danilo-alxnder/PowerAmplifier/Assigment.pdf

# Project part I: Design of an audio amplifier

## (CSC-CDC-AB configuration)

Abstract—An audio amplifier is presented and designed to drive a 4Ω-loudspeaker using an input signal of max 100mVRMS and power supply 10V. A three-stage-amplifier is used, starting with a common source circuit, next a common drain circuit, and ending with a class AB amplifier. This cascade is needed in order to get high input impedance, low output impedance, and efficient voltage transfer between stages. The distortion of the amplifier must be as low as possible. This is done by avoiding clipping and cross-over distortion.

I. INTRODUCTION

For the third module of Electrical Engineering at University of Twente, the task given was to design an audio amplifier. The required operating conditions are 100mVRMS input signal and a power supply of 10V. The audio amplifier is designed to drive a 4Ω loudspeaker. In order to accomplish this, first a common source circuit is used. This circuit has a high input impedance and is responsible for the voltage gain. Given the mentioned constrains to satisfy the requirements of a typical audio amplifier, the voltage gain must be around 30. Next, a source follower is implemented. This sub-circuit is used to achieve an efficient voltage transfer between the first and the last stage. Lastly, a class AB is used to deliver the current needed for the loudspeaker. This report will discuss the design process and the highlights of the audio amplifier. Experimental proof will be shown, and finally the issues faced while achieving this task will be discussed.

II. ANALYSIS AND DESIGN

A step by step explanation for the design process of the circuit stages will be done in this section. The schematics in the figures are from the final circuit itself.

A. STAGE 1: COMMON SOURCE CIRCUIT

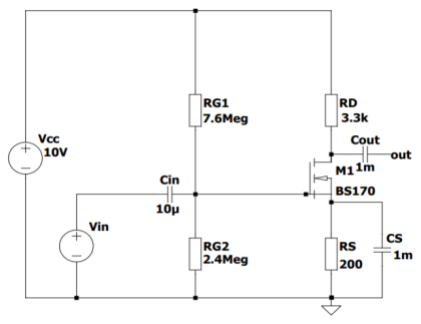
[picture p1: figure]

Figure 1 Input stage; common source circuit

The input impedance of the common source circuit is relatively high. This is needed for maximum transfer from the input source (e.g. laptop audio port) to this first stage. The circuit behaves as a voltage divider: in order to get most of the voltage to the first stage its input impedance needs to be high in comparison to the impedance of the signal source. This stage also delivers the voltage gain, given by the following equation: AV = −gm ∙RD [1] (the minus is not included in the rest of the calculations, because this does not affect the performance of the audio amplifier). In order to get enough gain, the resistor values are calculated using the equations for the given stage which were fitted for biasing. Also, the bias settings need to be in such a way, that the output voltage can get maximum swing. This means that the bias voltage at the output of this stage needs to be approximately 6V. The positive peak can then reach the supply voltage VCC, (the amplitude of the output signal of this stage is 4V, and the minimum value is 2V), which is just above the threshold voltage of the MOSFET. A gain of 30 is the maximum possible, because 0.141∙30 = 4.23V, which is about the maximum voltage swing. The output impedance is approximately the same as RD, which is relatively high, so a buffer stage is needed.

The resistor values need to be calculated. Firstly, the gain needs to be 30. But it is known that there will be some loss in the source follower, so for the calculations 32 is chosen. The output bias voltage of this stage is chosen to be 6V, because then maximum swing is possible (not 5V, because of the threshold voltage).

ID =

VCC−Vout
RD
→ IDRD = 4 | (1)

Also, the voltage gain equation is known K =0.04 A/V² and VT =1.9V (same value as discussed in the measurement section.)
AV = gmRD = √2KIDRD = 32 → RD = 3.2kΩ (2)

An available resistor value will be chosen: 3.3kΩ Then, the other resistances will be calculated. The equation ID =
1
2

K(VGS − VT)

2
is known. Then:

VG − VS = √
2ID K
+ VT = VG − IDRS | (3)

The value for RS may not be too high, because clipping at the negative side of the signal can occur. Therefore, RS = 200Ω is chosen to avoid this issue. Thus:
VG = √
2ID
K
+ VT + IDRS ≈ 2.4V | (4)

Then the bias values for the gate are quite easy: RG2 = 2.4MΩ and then RG1 = 7.6MΩ.

B. STAGE 2: COMMON DRAIN CIRCUIT

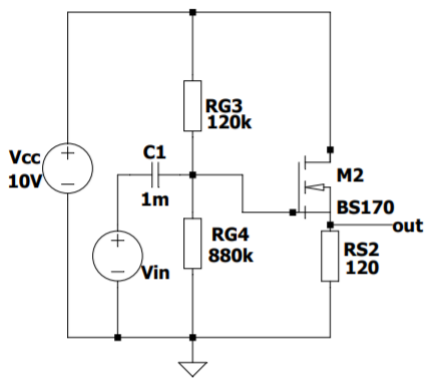
[picture p2: figure]

Figure 2 The common drain circuit

The second stage is a common drain circuit, which has a high input impedance and a low output impedance, perfectly fitting between the first and last stage. The gain will be always lower than 1 (see the equation in Table I), but there will not be a significant loss if it is close enough to 1. Therefore, this gain is calculated and set at least 0.90, because then the loss is acceptable. Moreover, the output impedance may not be too high. Therefore, RS cannot be too big or too small. Choosing a value of 120Ω, RG3 and RG4 can be calculated, using equation 4 again. Choosing ID = 50 mA, results in RG3 = 120kΩ and RG4 = 880kΩ. These resistor values result in rout=9Ω and AV = 0.93. The equations used for calculating this are shown in Table I.

Table 1 SMALL SIGNAL PROPERTIES OF THE SOURCE FOLLOWER [1]

Voltage gain | gmRS AV = gmRS + 1
rout | 1 gm
rin | RG1//RG2
C. STAGE 3: CLASS AB AMPLIFIER [2]

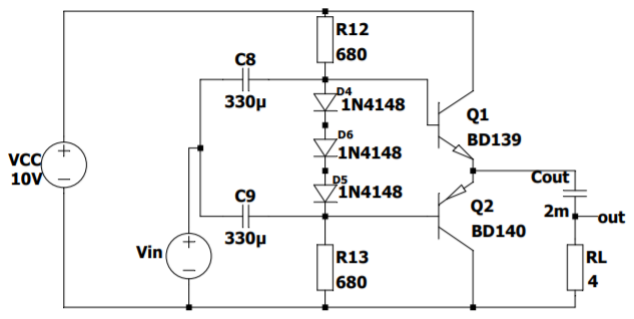
[picture p3: figure]

Figure 3 The class AB-amplifier

Up until now the two stages previously discussed will deliver an amplified input signal. The next step is used to ensure a maximum current driving to the load. This would have not been possible with the first two stages. Their transistors always consume power even if there is no input signal, therefore, providing less current and less power. A solution for this is to implement a class AB amplifier. They not only have a low output impedance but also low distortion when properly biased.

Thus, in order to accomplish this, the following considerations are taken:

a) The use of a fixed biasing voltage allows each transistor conduct one-half of the input cycle.
b) To put the transistors in active operation a voltage difference between the base and emitter of each BJT must be higher than 0.6V.
c) The current seen at the load depends on the output impedance of the power transistor.
d) Since the circuit acts as a pull and push amplifier one of the transistors will take charge of the positive half input signal. Thus, reducing the analysis to only one transistor. Such one being a common collector circuit.
e) Lastly, because power dissipation is avoided a cascade of diodes (instead of resistors) meeting the condition of literal b) is required.

All things considered, Figure 3 can be treated as a common collector circuit, when the input signal is at its positive side. But when the negative part of the signal, the other transistor is working. First, the diodes between the pair of transistors is shorted. Their resistance is negligible and make calculations easy. Secondly, the PNP transistor is seen as an open loop until the negative part of the input signal is reached. Then, the 4Ω resistance is placed as the load of this new configuration. Calculating the transfer function of this set up, the following equation is obtained:

Vout

Vin

=

gmRL
1+ gmRL

Now, since a common collector circuit acts a voltage buffer a gain of 0.99 is chosen. Thus
100
1 +100 =

gmRL
1+ gmRL

Equating both sides and solving for IC:

IC =

100
40 ∙ RL

= 625mA

Where gm ≈ 40IC stands for the transconductance of the BJT power transistor. The next step is to calculate the resistor values with the current obtained in the above equation. This is done by realizing that the node where both transistors meet each other is at 5V. Thus, for the common collector circuit of this analysis, the voltage over resistor R12 should be 4.4V. Looking at the datasheet of the transistor used in the real circuit it is found that the current gain is around 100 when IC is 625mA. Applying Ohm’s law this results in 700Ω. During measurements the available resistor value of 680Ω was chosen as it did not affect the biasing.

Table 2 SMALL SIGNAL PROPERTIES OF AB AMPLIFIER

Voltage gain | gm(1+∝)RL AV = ∝ +gm(1+∝)RL
rout | ∝ RL// gm 1 + gm (RL// ∝ ) gm
rin | RL(1+∝)//(RB1//RB2 )
D. WHOLE CIRCUIT

When connecting the three stages to each other, the complete amplifier is the result. This circuit can be seen in Figure 4. The gain for this circuit is not exactly the same as the gain of the common source circuit , because the gain of the source follower and the AB amplifier is less than 1. When multiplying those two voltages gain equations, the result is: AV = 0.99 ∙ 0.93 ∙ 32 ≈ 29.

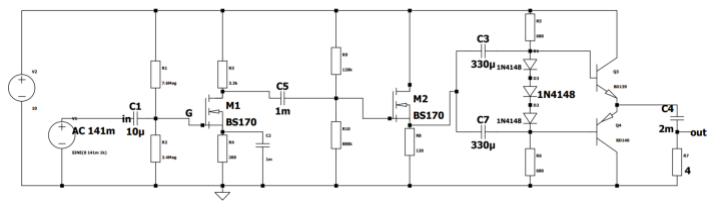
[picture p4: figure]

Figure 4 The complete amplifier circuit

III. RESULTS

A. Simulations

In this section, the simulations of the total amplifier circuit are presented:

Voltage Gain

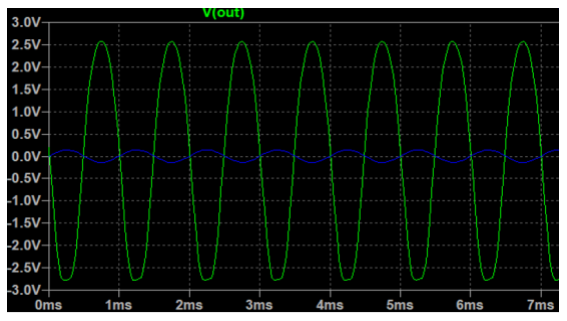
[picture p5: figure]

Figure 5 Simulation Voltage Gain

Starting with the voltage gain. A proper biasing for the different stages resulted in Figure 5. There, in green colour the output signal is shown. A close analysis reveals an amplitude of 2.7 volts. This corresponds to a voltage gain of around 20.
Bode plot

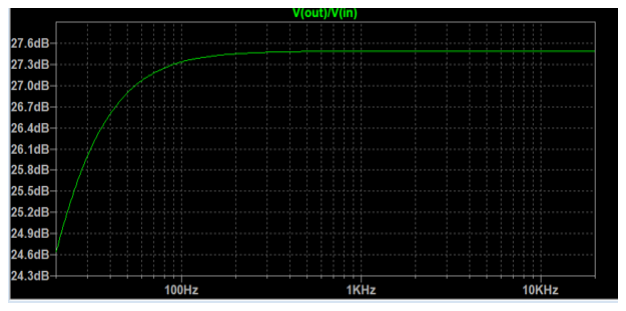
[picture p6: figure]

Figure 6 Simulation Bode plot

Figure 6 presents a Bode plot obtained in LTSpice. Looking at the top part in the y axis, a voltage gain of 23 is calculated. This corresponds to 27,4 dB within a bandwidth of 20Hz to 20kHz.

Distortion

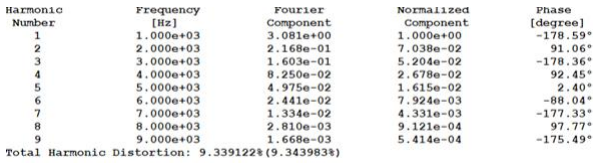
[picture p7: figure]

Figure 7 Screenshot of THD simulation

Accounting to the fact of a slightly distorted signal at the negative peaks where it is not perfectly rounded, an analysis to measure the distortion of the audio amplifier was carried out. [3]. This resulted in a THD of 9.33% as it can be seen in Figure 7.

Input impedance

The input impedance in the simulation is calculated using the values of the current passing through the input terminal and the voltage across it. Using Ohm’s Law, the result is 2,02MΩ

Output impedance

In a similar manner, the impedance as seen at the output terminals of the audio amplifier is 0.031Ω

B. Measurements and Performance

Before collecting measurements, in order to match the K parameter of the MOSFET used in the first two stages and the one in simulations, a test with my-DAQ is run. A set of instructions is followed. MATLAB is used and the transistor analyser studied during Lab sessions is put into practice [4]. It is found that the K-value is 0.04 A/V²
and the threshold
voltage is 1.9V. Marginally different, reason for which these parameters were changed during simulations. With this set up the biasing is readjusted, and the measurements are taken.

Voltage Gain

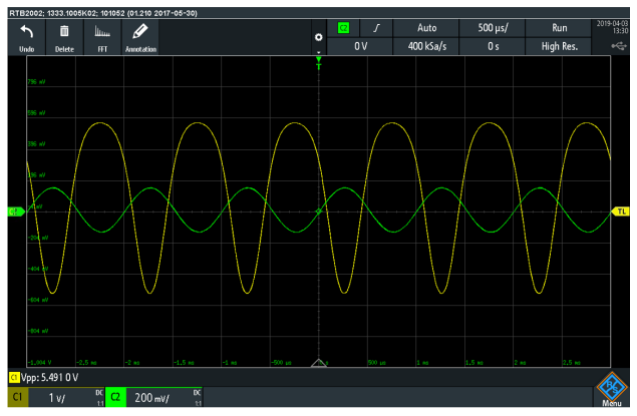
[picture p8: figure]

Figure 8 Real amplifier voltage gain; green: input, yellow: output

Figure 8 shows the output signal in the real circuit. The yellow line corresponds to the output signal whereas the green one to the input. A voltage of 5.49 peak to peak is observed, thus, calculating an amplitude which produces a gain of 19 times.

Bode plot

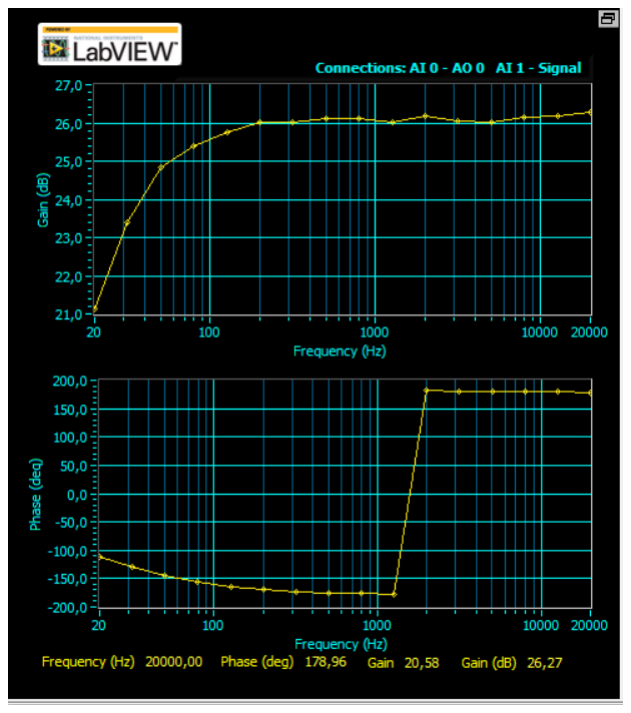
[picture p9: figure]

Figure 9 The measured Bode Plot

In figure 9 the analysis done with the Bode Analyser of my-DAQ is shown. In the window one can see that the cut-off frequency is rounding the 30Hz. This can be explained due to a relatively small (330μF) output capacitor which was used when doing this measurement. When a bigger capacitor (2mF) was used instead of the previous one, the cut-off frequency would have been lower than 20Hz, just as in the simulation. The gain in this figure is 26dB (20 times).

Distortion

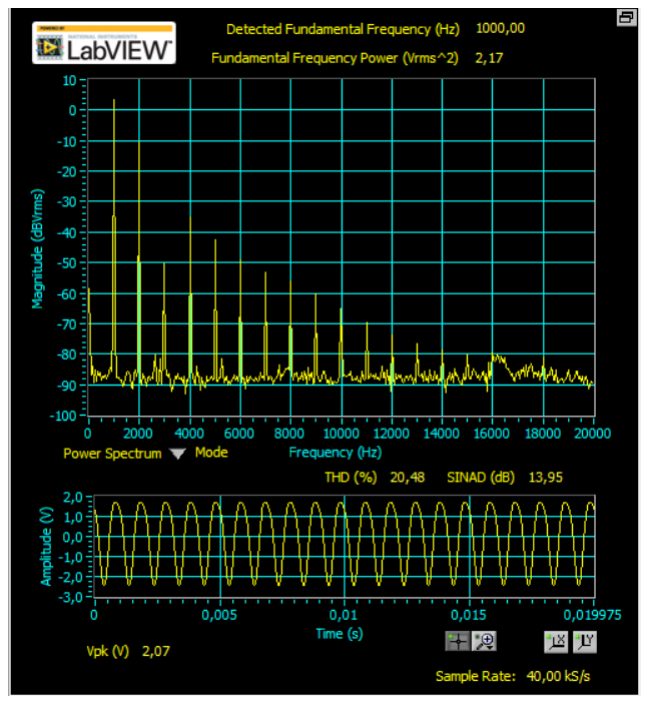
[picture p10: figure]

Figure 10 Measured Fourier transform

In Figure 10, the Dynamic Signal Analyzer was used to analyse the real circuit. As shown, the level of distortion THD is approximately 20%. This value, however, can be observed when looking to the output wave, in Figure 8. There, the yellow sinusoidal wave being the output presents positive peaks that are significantly wider than the negative ones. The green line is the input of 100mVRMS, and it used as a point of reference.

Input impedance

The value for the impedance is determined by measuring the current and the voltage seen at the input ports of the audio amplifier; 1.28 MΩ is obtained. The multimeter used for this purpose was the Agilent 34401A Multimeter and the calculation was done using Ohm’s law.

Output impedance

Applying the same concept to measure the input impedance the value obtained during real experimentation resulted in 0.062Ω. This time, the current measured was at the node of the emitter between the two power transistors and the load. Similarly, the voltage used in this case was the output voltage gain.

Table 3 Performance summary

Characteristics | Simulated | Measured
rin | 2.02MΩ | 1.28MΩ
rout | 0.031Ω | 0.062Ω
AV | 23 | 19
THD | 9.33% | 20%
Bandwidth | 20-20kHz | 30-20kHz
IV. | DISCUSSION AND CONCLUSION

Throughout the process of design, simulation, and testing, some issues became apparent which needed to be resolved.

One of the issues faced was the unknown k-factor. Thus, the first trial was done using the value of the k-factor from

LTSpice, however this resulted in distortion. This was resolved by implementing a proper method to derive the value for the used MOSFET, namely the method used in one of the labs of the third module.

In the pitch, the circuit design was slightly different than it is now. Some changes have been made, listed down here:

1. Capacitor values changed. Some capacitor values were chosen too big (1 mF for most of them). This would result in a high time constant τ (around 4s). This is avoided by choosing lower capacitances.
2. The resistor values have changed. Biasing was not done very properly. Also, the biasing was done using the simulation K and VT, which are not the true values.
3. The input of the class AB was placed between the two diodes during the pitch. Because crossover distortion was happening, another diode was added to ensure the required bias voltages at the bases of the transistors. Therefore, the input was split into two different inputs, otherwise it could not be in the middle of the diodes.
4. The biasing of the source follower was first done by using the bias voltage of the input stage, but because this one was changed, also this bias changed. That is not wanted, so two biasing resistors were added to this stage.
5. For the transistors at the output stage, first the BC550 and the BC560 were chosen, however these transistors cannot handle the required current. Therefore, they are replaced by high current transistors (BD139 and BD140).

The aim of this project was to design an audio amplifier circuit which fits the requirements and restrictions given. The final circuit design was able to drive the 4-ohm loudspeaker with the limitation of 10V supply, however distortion was clearly audible. This was seen through the distortion levels of the output signal (Figure 10). Taking this into consideration, the design of the amplifier circuit could be improved in some areas. For example, the bias settings could be improved even more. Also, by boosting the supply voltage (e.g. using a step-up-converter) the amplification could have been higher while clipping and other kinds of distortion would be avoided more.

Another improvement that can be made, is to add a heatsink to the power transistors in the class AB amplifier, because they were heating up significantly.

V. REFERENCES
1. A. J. Annema, ELECTRONICS. Oct 2018. https://app.perusall.com/courses/electronics-2018-2019/bookelectronics (https://app.perusall.com/courses/electronics-2018-2019/bookelectronics)
2. https://www.electronics-tutorials.ws/amplifier/class-ab-amplifier.html (https://www.electronics-tutorials.ws/amplifier/class-ab-amplifier.html) Accessed: 04/04/2019
3. Michiel, “Amplifier THD Simulation,” Canvas. [Online]. Available:
https://canvas.utwente.nl/courses/3258/pages/circuit-simulations?module_item_id=52685. (https://canvas.utwente.nl/courses/3258/pages/circuit-simulations?module_item_id=52685)
4. A. J. Annema and M. O. Alink, Module 3 Project and Lab Exercises Manual 2018-2019. .. https://app.perusall.com/courses/electronics-2018-2019/module-3-projectmanual_2018-2019_v3a (https://app.perusall.com/courses/electronics-2018-2019/module-3-projectmanual_2018-2019_v3a) Accessed: 02/04/2019
