danilo-alxnder/PowerAmplifier/Distortion.jpg

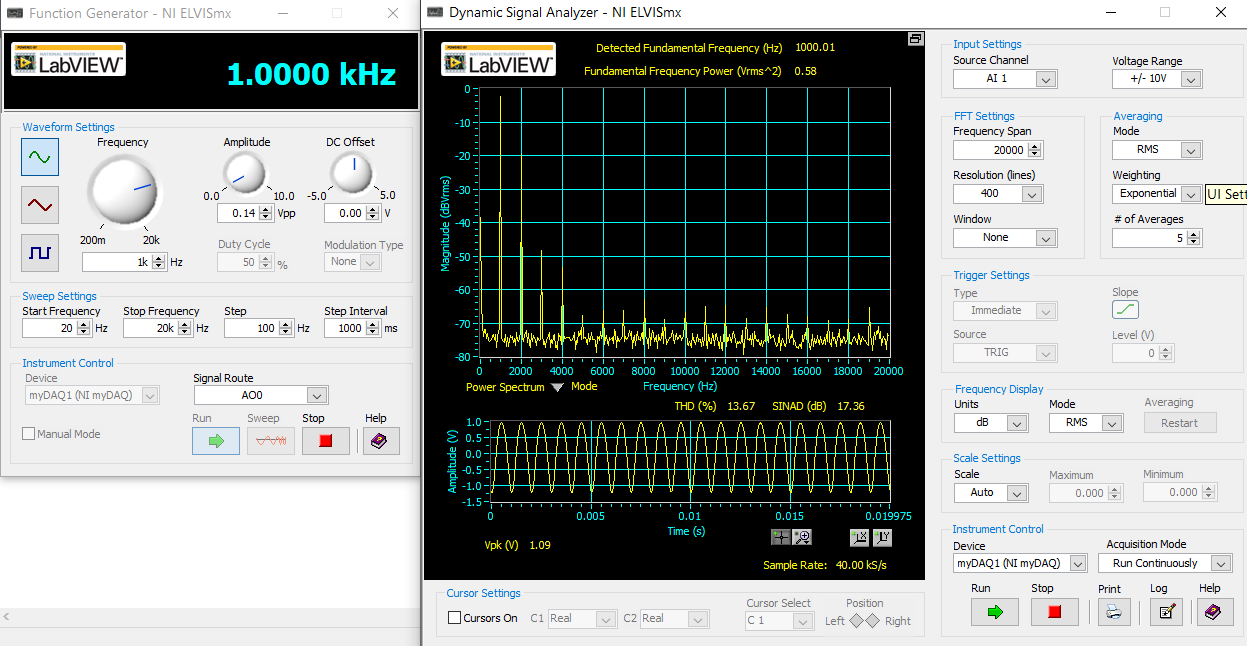
Distortion.jpg
