danilo-alxnder/PowerAmplifier/Oscilloscope_data.PNG

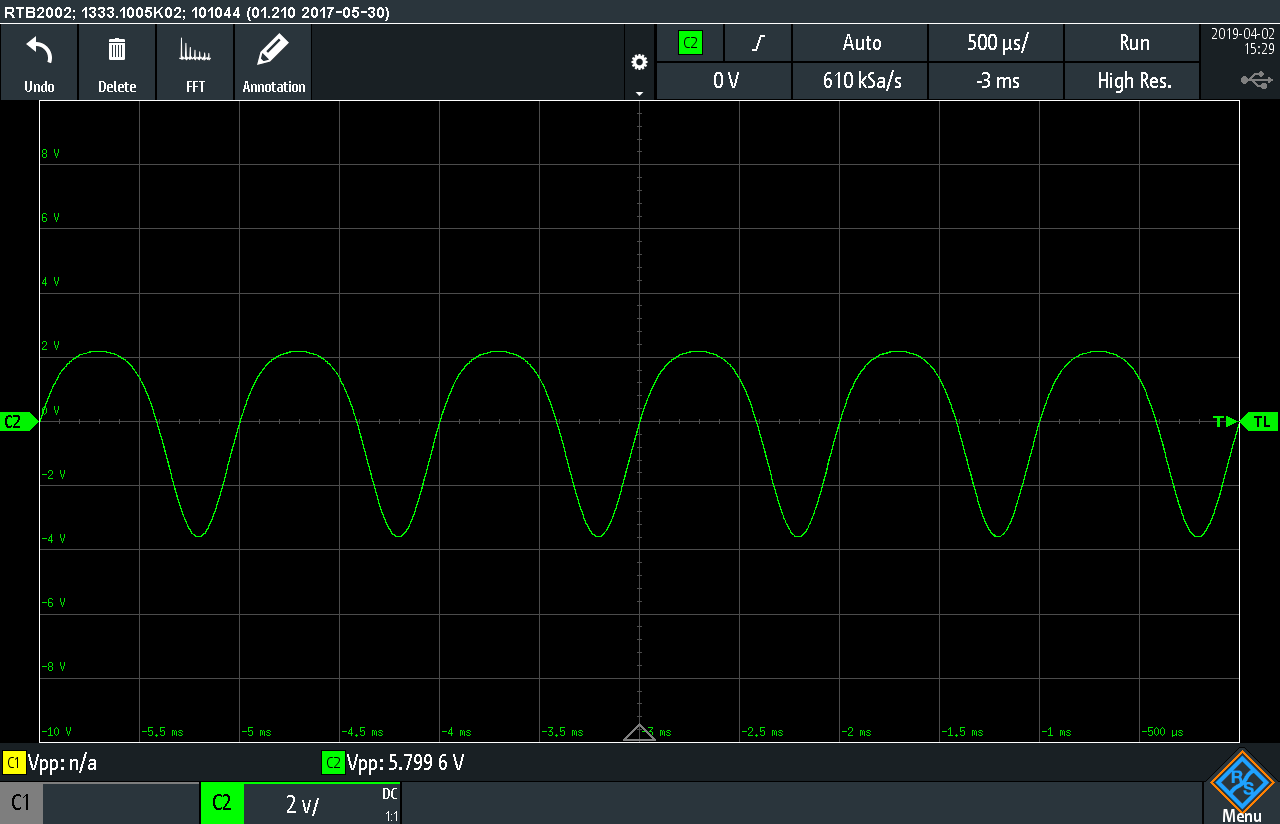
Oscilloscope_data.PNG
