danilo-alxnder/PowerAmplifier/CSC circuit amplifier.asc

C1: cap; 1m
C2: cap; 10µ
C3: cap; 1m
C4: cap; 10µ
C5: cap; 10µ
M1: nmos; BS170
M2: nmos; BS170
R1: res; 7k
R2: res; 3.6Meg
R3: res; 1Meg
R5: res; 6k
R6: res; 9k
RD: res; 9k
RS: res; 406
V1: voltage; 10
V2: voltage; SINE(0 100m 50)
V3: voltage; 10
V4: voltage; SINE(0 100m 50)
Named nets: 0, Vout, Vin, Vin1, Vout1
.lib BS170.sub
.tran 0 1.1 1 0.01
